Linhcry/modular-robot-pet/docs/02_电机来源与接口决策.md

# 电机来源与接口决策

记录日期：2026-09-05。阶段：结构设计。本文不构成采购订单；价格只用于方向比较，驱动板选项与正式报价尚未冻结。

| 型号（不得与 V3.0 混用） | 厂家额定扭矩 | 峰值扭矩 | 电压 | 厂家尺寸 | 厂家参数表质量 | 拟评估用途 |
|---|---:|---:|---:|---|---:|---|
| CubeMars AK40-10 KV170 | 1.3 N·m | 4.1 N·m | 24 V | 直径53×37 mm | 185 g | 轻载偏航、手臂末级；承载髋轴须另算力矩 |
| CubeMars AK45-10 KV75 | 2.5 N·m | 7 N·m | 24 V | 直径53×43 mm | 260 g | 髋部俯仰、机械臂肩部候选 |
| CubeMars AK45-36 KV80 | 8 N·m | 24 N·m | 24 V | 直径55×54 mm | 340 g | 承载膝轴候选 |
| 飞特 STS3215，7.4 V 规格书版本 | 约0.490 N·m | 堵转约1.91 N·m | 7.4 V | 45.23×24.73×35 mm壳体 | 55 g | 头部、尾部、夹爪、舱盖候选 |

## 可在中国购买的型号证据

CubeMars 中文官网均有购买入口、国内配送及支付宝信息：

- [AK40-10 KV170](https://www.cubemars.com/cn/product/ak40-10-robotic-actuator.html)
- [AK45-10 KV75](https://www.cubemars.com/cn/product/AK45-10-robotic-actuatuor.html)
- [AK45-36 KV80](https://www.cubemars.com/cn/product/AK45-36.html)
- [飞特 STS3215 厂家产品索引](https://www.feetechrc.com/products.html?keyword=STS3215)

AK40-10 页面宣传段落另出现200 g，与核心参数表185 g矛盾。当前表格明确采用参数表值，质量预算需另加配线与安装余量。飞特索引包含12 V与7.4 V版本；已下载规格书属于7.4 V版本，不能拿该文件的电气额定参数替代12 V版本。

## 已保留原始资料

- AK45-10 厂家 STEP 压缩包已完整下载并通过 ZIP 校验；内部文件由 SolidWorks 2020 导出，AP214，文件日期2025-02-28。
- AK45-10、AK45-36、AK40-10 厂家二维尺寸图。
- AK40-2410-1A-A1 驱动器安装说明 V1.0.2，以及 STS3215 7.4 V 规格书。
- 原文件放在 `vendor/motor_sources/`。厂家文件保留原貌，自制模型不得伪装成厂家原始模型。

## 接口建模规则

1. 旧 J01/J02 为早期几何假设，不能作为最终电机或采购件。后续必须用明确型号替换，或改为有来源的外形/接口简化模型。
2. AK40-10 尺寸图显示五个 M2.5、深5的孔位于直径45分度圆；另一端直径47.5与27分度圆上分别三孔，深度分别5与3。定子与输出端角色需对照厂家三维结构再冻结安装方式。
3. AK45-10 与 AK40-10 外径相同不代表轴向尺寸、输出位置与安装螺纹深度完全相同。AK45-36 孔型又不同，不允许沿用早期44方孔。
4. 未核实的背面插头、配线弯曲半径和散热空间应作为独立避让包络，不能用不明孔位制造安装件。
5. 驱动器说明列明：额定24 V、允许16–28 V、CAN 1 Mbps；电源接口 XT30PW-M 配 XT30U-F，串口 A1257WR-S-3P 配 A1257H-3P，CAN A1257WR-S-4P 配 A1257H-4P。驱动板安装孔2.1 mm、推荐M2螺钉，不能套用电机壳体M2.5孔。

## 选型冻结前的力矩与质量检查

峰值或堵转扭矩不作为持续承载指标。例如300 g物体在距肩轴240 mm处，仅物体产生约0.706 N·m重力矩，已高于所下载STS3215的额定扭矩，还没有计入手臂自重。因此该舵机不直接承担长臂肩关节。

若四腿分别采用每腿两台AK45-10与一台AK45-36，仅腿部12台电机的参数表质量就达3.44 kg。这会明显挤压4–5 kg整机目标留给结构、机械臂、电池与计算模块的余量。该组合尚未冻结；需结合CAD质量、支撑姿态与减重方案选择，不能把初选型号等同于整机指标已达成。

后续应建立各承载轴的最差静态姿态、运动峰值、持续工作占空比、温升与跌落工况，再确定驱动等级。CAD可验证外形、装配和部分运动包络，不能单独证明爬楼承载性能。
