Linhcry/modular-robot-pet/docs/04_电机载荷计算与减重决策.md

# 电机载荷计算与减重决策

版本 P1.1，2026-09-05。当前是选型筛查，尚未锁定最终电机，也未进行实物试验。

## 结论与设计变更

现有厚板、转接盘和长滑靴组合不能按 4–5 kg 目标直接推进。按已建实体体积、拟装数量、候选完整电机质量及尚未建成部件的质量预留，本体估计 **10.337 kg**，另有 300 g 货物。这不是总装质量属性或成品称重；详细数量与证据逐项列在 `data/当前架构质量估算.csv`。

新增 F10/F11 减重承载板和 B01/B02/B03 曲面护罩为独立候选件，不覆盖已检查的原版。它们的实际生成与重建状态以 `validation/减重框架与护壳检查.json` 为准；脚本存在不等于模型已成功生成。两个薄板不能只凭减重比例就代替刚度、屈曲和连接强度校核。

最终电机必须同时满足计算和大工程师模型来源要求。AK45-10 厂家模型及已建关节装配保留为接口研究；不能将其描述成已经从大工程师取出的最终电机。

## 输入与可复算文件

- `scripts/measure_part_volumes.py`：逐件打开原生模型、读取体积、关闭；密度假设保存在 `data/零件体积与质量假设.csv`。
- `scripts/size_actuators.py`：质量预算、三轴腿静力/集中质量动力筛查、60 s 载荷谱 RMS、辅助关节载荷。
- `data/腿部电机工况计算.csv`：每个关节、姿态、地面力、加速项、速度项、裕量、转速和持续时间。
- `data/腿部连续力矩筛选.csv`、`data/辅助关节载荷计算.csv`：选型输入。
- `validation/电机载荷初算.json`：汇总与数值检查。修改长度、质量、速度、载荷分配后必须重算。

材料密度暂按 6061 铝合金 2700、PA12 1010、TPU 1200 kg/m³ 等设计值。打印件按完整实体估计；填充、嵌件、表面处理和制造差异需要后续实测。V01/V02 是同一电机的接口参考，不能各按一台电机计重。标准螺钉未逐颗叠加到质量总表，而由整机紧固件预留项覆盖，避免重复。

## 腿部模型与方法

坐标 X 向前、Y 向左、Z 向上；大腿、小腿轴距均为 145 mm，髋外展轴至髋俯仰轴横向偏置暂定 50 mm。外展角为 r，髋俯仰为 h，膝俯仰为 k，俯仰零位是竖直向下。

足端位置：

`p = Rx(r) · [L1 sin(h) + L2 sin(h+k), 0.050, -L1 cos(h) - L2 cos(h+k)]`

每个雅可比列为 `轴方向 × (足端位置 − 关节原点)`；地面力对应 `τ = JᵀF`。该静力关系依据 [Modern Robotics：速度运动学与静力学](https://modernrobotics.northwestern.edu/nu-gm-book-resource/velocity-kinematics-and-statics/)。脚本采用两种可手算姿态及中心差分验证雅可比，当前最大误差约 2.63×10⁻¹¹ m/rad。

地面垂向载荷取 `Fz = 满载质量 × g × 动载系数 × 单脚载荷份额`；Fx/Fz、Fy/Fz、各关节速度和角加速度均在脚本中明确列出。它们是筛查假设，不是已规划的真实步态时序。

连杆/转接件/膝电机/足部暂按集中质量计算 `M = Σ m JpᵀJp`；利用 M 的差分导数计算科氏与离心项，遍历给定速度幅值的 8 种方向组合。加速项按各耦合分量绝对值求和。最后将地面力矩、腿重、集中质量加速项和速度项的幅值相加，再乘 1.25 筛查裕量。这保留了集中质量模型的耦合，但不等于完整刚体逆动力学。转子反射惯量、零件自身转动惯量、内部减速摩擦、弹性和接触冲击尚需补入。

由于姿态、载荷和速度采用组合边界，筛查值可能高于某条可实现慢速轨迹的实际需求。不能用一次边界筛查直接断言某电机绝对无法行走；也不能用静态通过证明跳跃、跌倒翻正或连续楼梯通过。

## 初步数值

60 s 示例载荷谱：安静站立 30 s、三脚慢走 12 s、伸爪支撑 8 s、低姿爬行 5 s、爬阶推升 5 s。RMS 为 `sqrt(Στ²t / Σt)`，不是各工况峰值的算术平均。

| 本体场景（另加300g） | 髋外展 RMS | 髋俯仰 RMS | 膝俯仰 RMS |
|---|---:|---:|---:|
| 5 kg 目标场景 | 3.001 N·m | 2.122 N·m | 3.259 N·m |
| 当前架构约10.337 kg | 5.163 N·m | 3.570 N·m | 6.254 N·m |
| 7 kg 敏感性场景 | 3.811 N·m | 2.659 N·m | 4.381 N·m |

均含 1.25 筛查裕量；腿部局部质量尚采用当前候选构成，整机减重后必须同步修改这些局部质量。

在 5 kg 目标场景下，爬阶推升组合边界对应髋俯仰约 6.203 N·m/47.75 rpm，膝俯仰约 7.500 N·m/66.85 rpm。小跳起蹬的膝转速边界为 171.89 rpm。故不能看到高减速比型号扭矩较大就直接选为膝电机。

单脚误着地另外列为故障边界；不能将它混入普通动作通过率。跌倒翻正需要加入身体圆弧接地、重心位置、滚动过程和腿推力轨迹，目前没有计算闭环，保留为未完成项目。

## 候选电机对照

| 候选 | 厂家公开额定/峰值 | 转速/质量 | 本轮判断 |
|---|---|---|---|
| CubeMars AK45-10 KV75，非V3 | 2.5/7 N·m | 额定150 rpm；260 g | 当前组合边界下髋外展连续需求不足；髋俯仰还有热条件和峰值时间待核。仅作候选接口研究 |
| CubeMars AK45-36 KV80，非V3 | 8/24 N·m | 额定40 rpm、空载52 rpm；340 g | 具有低速扭矩，但当前快动作转速边界不满足；不能按24 N·m概括为全动作适用 |
| 大工程师：姜莱 BK10 | 库中已选到BK10规格；属于减速机 | 完整电机与驱动参数未取得 | 不能当作一体化电机。下载对话框已出现，尚未成功保存模型 |
| 大工程师：CHAMP系列、KGU系列 | 已看到产品条目 | 具体可选规格尚待进入详情 | 继续检索，尚未选型 |
| 大工程师：德晟120 kgf·cm总线舵机 | 已看到库条目 | 连续扭矩、实际型号和质量未取得 | 不能把标题里的kgf·cm当连续工作扭矩 |

AK 系列数据来自 [AK45-10 厂家页](https://www.cubemars.com/cn/product/AK45-10-robotic-actuatuor.html) 和 [AK45-36 厂家页](https://www.cubemars.com/cn/product/AK45-36.html)。V3 的轴向尺寸及编码器配置不同，不能与现有非V3接口混用。页面电流口径和减速器效率也不能擅自换算成电池峰值功率。

连续/RMS、峰值允许时间及转速必须联合筛选，并核对驱动器和实际散热条件，参见 [Kollmorgen AKM2G 性能曲线说明](https://www.kollmorgen.com/sites/default/files/public_downloads/AKM2G%20Performance%20Curves.pdf)。封闭宠物外壳中的热条件不能沿用大型散热板条件。

## 辅助关节

300 g 货物、双120 mm连杆、末端腕120 g和夹爪160 g、肘电机185 g的假设下：

| 位置 | 含1.5裕量的初步驱动轴需求 |
|---|---:|
| 肩俯仰，水平伸展 | 2.968 N·m |
| 肘俯仰 | 1.224 N·m |
| 腕俯仰，物体质心距腕60mm | 0.402 N·m |
| 头俯仰，头220g、质心偏40mm | 0.181 N·m |
| 舱盖，含铰链80g | 0.117 N·m |
| 尾部竖直轴摆动 | 0.037 N·m |

夹爪以摩擦系数0.3、上提加速度2 m/s²、抗滑系数2计算，每指约需11.807 N法向力。若两指各40 mm力臂并由同一驱动同步，传动效率暂按0.7，则驱动轴需求约1.349 N·m。软包、钥匙薄边和低摩擦遥控器不应共用未经验证的抓取假设，需分别测试并保留托取指尖。

肩部优先研究近端布置电机、传动减速和重力补偿，避免把小舵机直接放在长力臂末端。腰转、头偏航和腕旋转还需要基于最终轴系与惯量补算，不能因重力绕竖直轴为零而认为无需选型。

## 减重路线与约束

1. 主板采用连续周边承载环、横向连接带及大圆角减重窗；孔位要落在承载带上。
2. 把关节适配盘与连杆端部整合，减少重复法兰与紧固件。电机库模型冻结前保持可修改接口。
3. 膝驱动研究近髋布置和同步带/并联连杆传动，降低摆腿惯量；新增轴承、同步轮、带预紧及传动损失全部纳入质量与扭矩预算。
4. 储物滑靴研究四个短滑靴替代两条长实心滑靴；防退出机构需要正向保持，不能依靠销自身重量。
5. 薄壳仅承担保护和外观，承载面与局部筋板保留平面。止口用于接缝定位，紧固件或锁扣另行承担保持。
6. 圆角半径、壳厚、通风和关节扫掠一起迭代。外观通过还须查看总装比例、缝隙、颜色及多姿态，而不是仅检查单件放样成功。

当前没有采购、询价消息发送或费用支出。用户正在使用电脑期间，暂停大工程师的前台鼠标键盘操作，继续计算、参数化脚本和后台CAD工作。
