Linhcry/modular-robot-pet/docs/05_减重候选与质量分配.md

# 减重候选与质量分配

日期：2026-09-05。保留原架构基线，不把独立候选当作已经完成的整机。

将 F10、F11、两件 F12、四件 Q05 代入，再用实际生成的两片机身壳和四件关节罩替换原来350g护罩预算，本体估计由 **10.337kg** 变为 **9.662kg**，净减重约 **675.0g**，距5kg仍差 **4.662kg**。这些质量来自原生实体体积、拟装数量和材料假设，并非称重结果或装配体质量属性。

| 变更 | 原估重g | 候选估重g | 减重g |
|---|---:|---:|---:|
| 下承载板 → 镂空下承载板 | 652.2 | 196.0 | 456.2 |
| 上承载板 → 双承载带上板 | 336.6 | 126.6 | 210.0 |
| 两条312长侧梁 → 两条300长避空侧梁 | 289.0 | 277.8 | 11.2 |
| 两条长滑靴 → 四个短滑靴 | 140.5 | 41.5 | 99.1 |
| 躯干护罩预算 → 两片机身壳+四个关节护罩 | 350.0 | 451.4 | -101.4 |

现有腿电机、辅助驱动、电池电子及线束紧固件的预留合计已约 **5.390kg**，尚未计入承载框架、四腿杆件、储物舱或机身壳。因此，继续给现有板件开孔不可能独自解决5kg目标；必须重做驱动和结构的一体化方案。

## 下一步设计门槛

1. 暂停冻结现有 AK45 接口为整机最终接口。按当前质量构成，12台完整驱动共3.44kg；目标分配暂为2.10kg，即平均175g/台。这是反推上限，不是已经找到满足力矩与寿命的电机。
2. 保留三轴腿和拾取机械臂任务。比较近髋膝驱动、共用轴承支承、连杆端与输出盘合并等拓扑，把新增传动件、损耗、预紧与维护空间一并计入。
3. 壳体预算需同时保留壁厚、局部连接柱和耐碰能力；不能把当前2.2mm壁厚按质量比例直接缩到不到1mm。
4. 对每个候选先计算慢走与爬阶的连贯轨迹，再核对扭矩—转速—峰值持续时间—散热。大工程师具体规格及模型未取得的候选不能定型。
5. 目标仍为本体4–5kg，另加300g载物。本报告不自动放宽目标、不触发采购。

## 5kg分系统目标

| 分系统 | 分配g |
|---|---:|
| 12台腿部驱动总成 | 2100 |
| 全部腿结构及传动支承 | 650 |
| 机身承载框架及模块接口 | 450 |
| 机械臂与夹爪含全部驱动 | 650 |
| 头尾储物舱含驱动 | 300 |
| 电池与电源保护 | 350 |
| 算力视觉音频 | 200 |
| 护壳 | 180 |
| 线束与全机紧固件 | 120 |

分项均为设计约束，尚无完整BOM满足；可在总额内调配。模型、质量表和载荷表一致后，才能作为进入加工或采购阶段的依据。
