Linhcry/modular-robot-pet/docs/06_单脚阶梯转移时序计算.md

# 单脚阶梯转移的连贯轨迹计算

2026-09-05；初步运动学/集中质量动力学，未验证整机连续楼梯。

按同一条抬脚、前移、缓降轨迹计算关节角、转速、角加速度和有符号力矩，避免把不同时刻的速度与扭矩峰值配成一个实际工况。每段使用端点速度和加速度均为零的五次曲线。抬脚0.8s，前移0.8s，落脚0.5s；足参考X从−20mm到130mm，假设阶沿X=40mm、脚参考点越过台阶顶15mm。

| 阶高/髋高 mm | 关节 | 角范围 ° | 最高转速 rpm | 摆动峰值 Nm | 峰值扭矩时转速 rpm | 摆动 RMS Nm |
|---|---|---:|---:|---:|---:|---:|
| 150/245 | 髋外展 | -0.0～0.0 | 0.0 | 0.545 | 0.0 | 0.492 |
| 150/245 | 髋俯仰 | -87.5～0.2 | 38.5 | 0.681 | 0.0 | 0.437 |
| 150/245 | 膝俯仰 | 64.1～148.0 | 31.6 | 0.236 | -9.7 | 0.199 |
| 180/275 | 髋外展 | -0.0～0.0 | 0.0 | 0.545 | 0.0 | 0.492 |
| 180/275 | 髋俯仰 | -87.5～0.2 | 38.5 | 0.681 | 0.0 | 0.415 |
| 180/275 | 膝俯仰 | 36.1～148.0 | 41.0 | 0.236 | -9.7 | 0.194 |

180mm阶高若仍保持245mm髋高，当前点足轨迹的膝最大角达160.1°；髋高提高至275mm后减少到148.0°。这表明上阶前身体高度必须参与规划，不能只抬小腿。这里的150°是观察线，尚未获得最终关节及足端实体全程无碰撞证据。

两种时间步长4ms和2ms的峰值力矩差已记录；IK回代已数值核对。此处扭矩均未乘选型裕量，仅为单腿摆动。支撑腿、翻正、跳跃、地面摩擦、电池功率和温升仍须分别验证；不能据此宣称整机已经能爬180mm楼梯。

方法沿用[Modern Robotics 的速度运动学与静力学](https://modernrobotics.northwestern.edu/nu-gm-book-resource/velocity-kinematics-and-statics/)，集中质量 M、重力和科氏项由现有模型计算。原始采样见 data/单脚150mm阶高转移时序.csv 和 data/单脚180mm阶高转移时序.csv。
