Linhcry/modular-robot-pet/docs/10_智能舵机候选与驱动筛选.md

# SM80BL智能舵机候选与传动筛选

2026-09-07。用户授权自行决定电机或舵机。本报告为候选筛选，不是最终选型或采购清单。

厂家2024-06-07 A/0规格书给出97.5±1g、46.5×28.5×34mm、RS485、位置/电流/温度等反馈，内部减速比353:1。第6–7页已视觉检查尺寸与曲线；不能按低减速比准直驱的背驱性能使用。

| 版本 | 标称额定 Nm | 堵转 Nm | 空载 rpm | 输入范围 V |
|---|---:|---:|---:|---|
| 12V | 1.961 | 7.845 | 62 | [9, 12.6] |
| 24V | 2.059 | 8.336 | 70 | [16.8, 25.2] |

本地厂家原件：[12V规格](../vendor/SM80BL_12V_厂家规格.pdf)、[24V规格](../vendor/SM80BL_24V_厂家规格.pdf)。[12V公开产品页](https://www.feetechrc.com/552209.html)。

## 筛选约定

沿用旧质量模型以隔离传动拓扑影响，三个局部支撑姿态的绝对力矩乘1.3，再除0.85作为传动不确定度余量。静态保持没有功率效率，这里的0.85是保守代理。比较额定值仅表示本设计采用“不依赖短时过载”的预筛，不证明超过额定的短动作绝对不可行。没有解全机平衡，也没有实测热曲线。

| 24V，外部比 | 轴 | 静态带余量 Nm | 对额定比 | 摆动最高 rpm |
|---|---|---:|---:|---:|
| 2 | 髋外展 | 2.096 | 1.02 | 0.00 |
| 2 | 髋俯仰 | 1.796 | 0.87 | 38.46 |
| 2 | 膝驱动 | 2.701 | 1.31 | 59.97 |
| 3 | 髋外展 | 2.096 | 1.02 | 0.00 |
| 3 | 髋俯仰 | 1.227 | 0.60 | 38.46 |
| 3 | 膝驱动 | 1.801 | 0.87 | 100.97 |

R2使膝扭矩降低，但带余量静态需求仍超过额定；继续加大比例又会增加近端驱动转速。不能把各自发生在不同时间的最大扭矩、最大速度拼成同一负载点。另一个CSV逐时刻检查R2轨迹：只在正机械功率区，用厂家直线速度曲线端点近似；制动和再生区单列为未验证。

厂家同时标注空载速度和堵转扭矩±10%。将两端点都下调10%的敏感性预筛中，12V的R2近端膝驱动已超出近似速度曲线，24V在当前电动摆动区仍有余量；这不是实测四象限工作包络，也不能覆盖静态额定、回生和温升问题。

## 本阶段设计决定

- SM80BL不作为全腿12轴通用直接替换；保留不同轴采用不同驱动的路线
- R2近端膝驱动继续研究，但本次带余量静态额定筛选未全通过
- 轻载头尾无需97.5g大舵机；优先更小的反馈舵机另核算
- 机械臂肩轴原需求约2.97Nm，SM80直接驱动额定不足；继续比较外部减速或更高额定型号
- 所有动力件在大工程师取得确切型号模型后再冻结接口；当前不采购

## 规格边界

- 24V输入上限25.2V与第5页默认过压25V不一致，电源阈值须确认
- 第6页寿命动作60度/0.25s与同栏30或35rpm口径待确认
- 规格书额定负载符号为20/21kg.cm≤；本筛选保守采用标称数，不解释为完整连续热包络
- 无外部径向/轴向承载及背驱测试数据
- 1kHz最大位置更新率不等于12轴总线实际全反馈频率

不能将80/85kgf·cm堵转扭矩当成连续能力。过流超过2.5A持续2s会关断输出，过温70°C也会关断；动作控制器必须识别故障并有序恢复。

舵盘图示外径18.8、4-M3孔在直径14分布圆、中心孔3.1、总厚5.4mm；图中25T文字仍写SM40BL，属于厂家图纸型号标注待核项。对侧凸台/支承面、30处M3×3深孔及线束出口需与实际大工程师模型交叉校验，尚未自制接口替代厂家模型。
