Linhcry/modular-robot-pet/docs/15_触控视觉头部与智能化接口规划.md

# 触控视觉头部与智能化接口规划

2026-09-08。本阶段完成结构候选和接口规划，不代表相机识别、触摸系统或大模型已在机器人上运行。沿用用户要求：中文独立零件、真实装配配合、后台建模、后续再采购。

## 头部机械接口

头壳 H04 采用四截面圆角放样和 2.5 mm 抽壳，后部曲面过渡至前端 104×96 mm 平面。H05 面框厚 2.2 mm，H06 承架厚 2 mm，H07 为独立黑色柔性密封圈。四个自制零件分别保存，旧 H01/H02 保留作历史方案。

四件自制结构按原生体积及材料密度假设合计125.25g，尚不含屏幕、相机、颈驱动、紧固件、算力和线缆。相对于旧H01/H02两件54.28g增加约70.97g；新方案增加了触控屏承架与齐平收口功能，并不是减重成果。旧整机9.662kg估算尚未合入所有最新候选，当前也没有证明满足4–5kg目标。

微雪 2.8inch DSI LCD 原厂 STEP 已保留并派生为 V03 中文原生参考零件，共 10 个实体。屏幕横置；原厂坐标到头部坐标为 X=-原Y-2，Y=原X-12，Z=原Z+61.1（mm）。玻璃外形名义 71.3×52.9 mm，面框开口 72.3×53.9 mm，周边 0.5 mm 刚性间隙由黑色柔性圈收口。按用户新增“无缝嵌入、高级感”要求，玻璃、面框、柔性圈前面均为 Z62.2，名义齐平；旧凹入0.8 mm方案已取代。

柔性圈总高 1.6 mm，装配原点 Z60.6。背部承边外形76.3×57.9 mm、厚0.6，面框沉台外形76.7×58.3 mm、深1.2；背面一圈0.6 mm薄唇将承边捕获在Z60.6至61.2之间。柔性圈从背面安装，承边弹性变形越过防脱唇，再恢复到槽内，避免圈体轴向游动使齐平面下陷。薄唇入口75.3×56.9 mm，过唇安装时每侧约需0.5 mm临时弹性变形。前方可见唇宽名义0.5 mm，与暗色面框配色统一。

上述为装配态名义几何，未模拟柔性变形。硅胶硬度、自由态过盈、成型收缩、公差、0.6 mm打印薄唇的成型/拆装耐久均需试样验证；不能直接把此装配态零件图当成模具图。真正的外观齐平还受玻璃/螺柱高度公差和承架装配偏差影响，后续通过试装确定垫片调整量；不采用刚性零间隙挤压玻璃。黑色柔性收口旨在隐藏亮缝，不宣称达到防水等级。

四个厂家螺柱轴线变换后 X=-29.35/30.12，Y=8.45/-32.45。孔距 59.47×40.90 mm，不能用对称居中孔距代替。螺柱后端平面由实体平面读取为原 Z=-9.9，变换后 Z51.2；承架顶同为 Z51.2，底为 Z49.2，头壳内部支承肩顶为 Z49.2。

原厂模型将螺柱命名为 M2.5，但内孔几何约 D1.76，与常规 M2.5 底孔口径不一致。承架先做 D2.9 通孔；紧固螺钉长度、有效啮合和螺柱具体供货版本待交叉确认，不能把模型孔径直接标成攻丝尺寸。

承架与头壳的四个M3孔已从X±37外移到±39，Y仍为±28。用SolidWorks临时实体对厂家屏幕做布尔相交，旧下方两孔的D5直进工具通道各与触控玻璃交叠约3.753mm³；外移2mm后清除。孔横距因此由74改为78mm。旧X37原生件和已交付PDF已留在wip历史目录，新图应使用78mm孔距。

`触控视觉头部_承架紧固候选.SLDASM`在五组件空间总成上增加四组M3×10螺钉、上下各一片0.5mm垫圈和2.4mm螺母，共21组件、44配合。夹紧路径为螺钉头→上垫圈→2mm承架→2.5mm头壳环肩→下垫圈→螺母，螺钉穿出螺母2.1mm。所有新增连接采用实际孔同心和承压面贴合，重开后无实体干涉；面框未安装时四处D5×60直进工具杆也避开头壳、屏幕和连接件。螺母防掉落、背面扳手路径及PA12预紧压溃/蠕变仍未解决，故仍是紧固候选。

2026-09-08已在国家标准全文公开系统核实：[GB/T70.1-2008内六角圆柱头螺钉](https://openstd.samr.gov.cn/bzgk/std/newGbInfo?hcno=AA481BA038B2F9CE68879E6B087F4F73)、[GB/T97.1-2002平垫圈A级](https://openstd.samr.gov.cn/bzgk/std/newGbInfo?hcno=199E0585386FDF8B9CACF6225BA5F924)、[GB/T6170-2015的1型六角螺母](https://openstd.samr.gov.cn/bzgk/std/newGbInfo?hcno=BDDE5AF77AC2FBC2D194289F10C69A4B)均为现行。螺母按该尺寸族预选，M3对边最大5.50mm、厚度最大2.40mm已通过[嘉立创FA尺寸表](https://www.jlc-jdgf.com/mcbook/GBT6170-2000.htm)交叉核对，与现有简化包络一致。尺寸族明确不等于实购件性能、镀层或全公差合格；材料等级、供应商货号与大工程师对应模型仍待冻结。详见`data/触控头部承架紧固装配清单.csv`及`validation/头部紧固件国标与装配清单核对.json`。

相机暂用独立于屏幕的上方区域：承架避空 26×25 mm，中心 Y30；面框镜头窗口 D16。将来相机装在可换小托架上，允许更换镜头/相机而只改局部零件。当前没有冻结相机孔距、镜头前伸量和视场锥，所以 D16 是空间预留，尚未证明视场无遮挡。屏幕玻璃前面不叠加机械展示用亚克力板。

相机采购候选进一步对应到Pi5-IMX219-77（SKU26184），厂家标称25×24mm板、6.5×6.5mm镜头、79.3°对角视场、2.85mm焦距和F2.0。按直线投影、名义入瞳半径0.7125mm及暂定0.5mm偏心预算，D16孔允许入瞳距面框前面后缩约8.19mm，即入瞳Z须不小于54.01mm。若入瞳在Z53，所需半径约8.84mm，孔径不足；Z55时名义径向余量约0.82mm。该预筛约束的是**入瞳位置，不是PCB位置或镜片表面**；真实入瞳、孔位、镜头前伸与实拍遮挡尚未取得，因此不能据此固定托架高度。计算见`validation/相机D16窗口条件预筛.json`及`scripts/screen_camera_aperture.py`。[厂家参数](https://www.waveshare.net/shop/Pi5-IMX219-77.htm)。

内部四个 2.5×10 mm 圆角扎带槽用于线束应力释放，后壁 D18 穿线口设 C0.3 去锐边。扎带槽不等于完整线束路径；排线端接、弯曲半径、护套、防拉脱和装配步骤仍须建模。安装结构必须把触摸按压力从屏幕螺柱传给承架与环肩，不能靠玻璃边缘硬顶面框承力。

## 计算与感知位置

高层控制候选为 Raspberry Pi CM5 + 微雪 CM5-NANO-A 底板，负责视觉、语音、表情、设置和网络模型接入。底板厂家 STEP 的首轮导入失败已恢复：改用ASCII临时路径、整体多实体导入并关闭自动导入诊断，本轮成功保存V04原生参考件，包含337个实体，原件约22.9MB。

V04保留厂家坐标：整体包围盒约X161.365至217.600、Y259.832至299.850、Z-2.800至9.000mm。厂家实体009为PCB，厚1.6mm；整体包围盒是CAD近似值，不能用它代替精确安装基准。PCB上已提取的圆柱孔全部小于1mm直径，未在厂家模型中找到常规安装螺钉孔，不能沿用核心板孔距直接给底板打孔。底板固定优先研究绝缘板边卡槽/压条，并核对器件与铜层禁压区；核心板、散热器和全部接插件尚未装入。

模型也需要与产品照片/原理图对照：尤其核验核心板板对板连接器和背面器件的三维完整性。厂家STEP存在并不意味着所有实物器件都画全，不把看似空白的背面当作已确认的支承面。[厂家产品与接口说明](https://www.waveshare.net/shop/CM5-NANO-A.htm)。

本轮已下载厂家原理图并作位号交叉核对。原理图中的CM1A/CM1B、J1/J3、H3/H5及按键/指示灯没有同名STEP产品标签，而USB-A、USB-C、MicroSD和GPIO位号能够对应。原始STEP没有开放曲面壳，不能简单归因于只导入实体而漏了开放曲面。此结果只证明标签追踪不完整，通用名称仍可能代表相关器件；后续须以几何位置或实物确认，详见`validation/CM5底板厂家三维覆盖核对.json`。[厂家原理图](https://www.waveshare.net/w/upload/8/85/CM5-NANO-A_Sch.pdf)。

CM5官方STEP及38页数据手册已通过公开官方链接下载并保留哈希。手册给出核心板55×40mm、PCB厚1.24mm±10%、四个M2.5安装孔距板边3.5mm。连接器选型会使叠层高度为1.5或4mm；对应安装后模块高度4.94或7.44mm。无线板载天线周围至少留10mm净空，天线下方不应直接放金属。上述尺寸用于核心板支承与避空规划，不能直接套用到底板；本项目还须核验实物版本及选用连接器。[官方数据手册，第16–17页](https://datasheets.raspberrypi.com/cm5/cm5-datasheet.pdf)、[官方设计文件](https://pip.raspberrypi.com/categories/1096-design-files)。

官方CM5R5 STEP已转换为`V05_树莓派CM5核心板官方参考.SLDPRT`，1076个实体，文件48,067,138字节；保存关闭后查看了预览。整体厂家坐标包围盒X0至55、Y0至40、Z-1.110至3.511mm。V05与V04仍是独立参考件，未假装已经完成板对板连接、散热或与头部的装配。

重开后的精确极值与孔轴提取：V05四孔圆柱直径2.7mm，轴线为X3.5/51.5、Y3.5/36.5，孔距48×33mm；这是M2.5螺钉的通孔几何，不能标成板上M2.5螺纹。V04大面积板体实际外形55.0186×40.0180mm，厚约1.6mm，仍无D1.6至4.2mm且垂直板面的圆柱孔。V05选中板体实体的厚度1.0762mm不能代替完整PCB叠层：原始文件含DIELECTRIC产品定义，夹紧厚度仍须厂家版本与手册核验。原始数值及SHA256见`validation/CM5核心板与底板精确接口.json`。

厂家明确提供一个 CSI 摄像头和一个 DSI 屏幕同时连接的示例。具体 2.8 寸屏驱动应使用该屏对应配置，不能直接沿用底板示例的 7 寸屏配置。[CM5-NANO-A 厂家说明](https://www.waveshare.net/wiki/CM5-NANO-A)、[2.8 寸屏厂家说明](https://www.waveshare.net/wiki/2.8inch_DSI_LCD)。

计算板装头部或机身尚未冻结。装头部可缩短 MIPI 线，却增加颈部惯量和触摸附近的热量；装机身可减轻头部，但必须验证穿颈线长、连接器空间与活动弯曲寿命。厂商示例 12 cm 屏排线不能直接视为本机够用。下一步先装入底板、CM5、散热器及连接器完整包络，再比较两个位置；给散热器留空间也不等于热设计通过。

## 智能体分层

| 层 | 职责 | 与机械有关的约束 |
|---|---|---|
| 触摸与表情界面 | 眼睛表情、音量、网络、模型选择、电量、模式设置 | 可触达、可清洁；界面旋转和触控坐标一致 |
| 感知层 | 摄像头、麦克风、IMU、距离/接触传感器；输出物体和环境状态 | 相机视场、麦克风隔振、热源与噪声距离 |
| 行为管理器 | 将“过来”“坐下”“打开储物舱”等意图映射到有限动作技能 | 每项技能有前置条件、运动边界、超时和恢复过程 |
| 模型适配器 | 按统一接口接入 GPT、DeepSeek 等服务，保存会话上下文 | 密钥在设置中管理；网络失联时基础交互仍可用 |
| 本地动作规划 | 关节轨迹、步态、姿态转换、夹取和储物流程 | 使用实际关节限位、载荷和碰撞模型 |
| 独立实时控制器 | 总线收发、位置/电流/温度反馈、看门狗、停止与恢复 | 与高层计算分离；按实测总线周期控制驱动 |

模型仅提出动作意图和参数，由本地行为管理器检查并执行。屏幕上的急停按钮只是辅助操作入口；实体停止控制及硬件执行路径要纳入电气设计。云端响应慢、模型错误或 Linux 界面退出时，实时控制器仍须有明确的关节保持/卸载策略，不能随意全部断力导致跌落。

## 配电与走线后续工作

- 将电机电源、逻辑电源和屏幕/相机线束分组，连接器有清楚的拔插方向和维护余量，强电不压住 MIPI 排线。
- SM105 候选是 9–16 V 输入；4 串锂电池充满 16.8 V 超出此范围，不能直接沿用为电源。电池串数、降压、回生吸收与保护待完整功耗和供电方案确定。
- 12 轴各自额定电流相加为 25.2 A，只能作为电源工况筛查输入，不能当作真实平均耗电或直接计算续航。动作占空、回生、压降和散热都须补齐。
- 总线安排要按真实指令/反馈帧长度、半双工换向时间和重试负荷计算；厂家标注单舵机 1 kHz 更新率不等于全机 12 轴都能达到此频率。
- 颈部采取有限角度活动和可维护线环，先明确目标偏航/俯仰范围，再用离散姿态与连续运动检查夹线。不能在普通排线条件下承诺无限旋转。

## 本轮验证边界与接续顺序

当前四件头部原生件与齐平面以`validation/触控头部最终孔轴复核.json`为准；21组件44配合紧固总成以`validation/头部承架紧固与工具空间检查.json`为准；完整/面框拆下/恢复完整配置及五页图纸以`validation/触控头部图纸交付复核.json`为准。五页合册首张已更新为紧固总成，主视图显示面框拆下状态，四张零件图使用78mm新孔距。当前头部不是制造释放总成，尚无屏幕螺钉、面框紧固件、相机小托架和完整线束。

接续顺序：齐平面与防脱圈几何复核 → 更新独立零件工程图和装配图 → 屏幕螺柱版本确认及紧固件 → 柔性圈试样/尺寸补偿 → 相机实际孔位与视场 → 计算板及散热布局 → 颈部负载和线束行程 → 与机身、机械臂、储物舱总装。驱动方面保留 SM105BL-C001 + R1.5 作为可深入设计的候选，须补大工程师对应型号模型、传动部件质量、承载轴承和热工况后才能最终选型。

## 2026-09-08 螺母防落改版与STEP完整性问题

H10/H11曲面定位头壳及长臂螺母杯已各自保存为原生单实体零件，零特征重建错误。新杯原点Z37.6，名义卸载间隙0.6mm；完整装配、安装路径与新工程图尚未完成。杯内独立检查完成4种状态、6个旋转反例，不代表头壳或实物装配通过。

轻量独立读取发现H04/H08/H10 STEP各有两条缺失曲线引用，不能用其不完整转换体验证无干涉。旧审阅包内的H04 STEP确认受影响，已补已知问题说明，并在重打包前增加拦截。原生SLDPRT是否存在相应几何问题尚需SolidWorks检查。详见 docs/16_螺母防落结构与STEP导出接续.md。
