Linhcry/modular-robot-pet/docs/03_储物舱与真实关节设计记录.md

# 储物舱与真实关节设计记录

日期：2026-09-05。阶段：P1 结构设计，未制造释放。此文件记录已经落实到原生模型的接口，不表示整机已经完成。

## 中文命名与保存

自制零件、采购参考件、装配文件及工程图均采用“编号＋中文功能名称”。保留 AK45-10、M2.5 等型号与规格。每个新零件建成后独立保存为 SLDPRT 并关闭，再按模型引用创建装配。厂家原始 STEP 与其原始结构另存，不能以简化件取代来源证据。

## 储物舱

- 储物舱模块包含 47 个实例、92 个真实配合。壳体是固定基准；舱盖采用同心轴线、轴向定位和可调角度配合。
- 舱体为圆角硬壳，盖体采用多截面放样与抽壳；安装处保留平面及螺纹凸台。
- 内托盘由四个支承柱托起，以避开舱底螺钉头；固定姿态配合可抑制后取出。
- 固定铰链采用双耳支承；活动铰链两颗螺钉防转。固定页增加圆角避让口，解决活动轴套开启时的实体碰撞。
- 铰链肩销为直径4、有效光轴长36.5，销端螺母压紧肩部，避免夹死活动页。
- 两条燕尾滑靴安装在舱底；滑轨、防退出销座与保持结构属于后续框架接口，尚未纳入本储物舱装配。
- 已检查 0、15、30、45、60、75、90 度七个姿态。配合无错误、无非预期实体干涉；每个姿态剩余8处均为M3公称螺杆与攻丝底孔的简化交叠。证据见 `validation/储物舱开启干涉检查.json`。

上述结果为离散姿态检查，不能替代连续扫掠、尺寸公差分析或实物试装。舱盖的驱动和闭合保持、快拆销的防跳脱结构仍待完成。

## AK45-10 几何来源与坐标

厂家型号为 CubeMars AK45-10 KV75，非 V3.0。厂家中文销售页显示采购入口及国内配送；外径53、总厚43 mm、完整电机参数表质量260 g。价格和驱动板选项尚未冻结。[厂家产品页](https://www.cubemars.com/cn/product/AK45-10-robotic-actuatuor.html)

从厂家 STEP 中提取后端盖、定子壳体、固定端环和输出法兰，保留原始实体几何并变换坐标：

`X=厂家X，Y=厂家Z，Z=30.5-厂家Y`，单位 mm。

因此 Z=0 为背面安装面，Z=43 为输出端面。V01 为三个外部定子构件的组合参考体，V02 为输出法兰参考体；两者合计代表一台采购电机。内部齿轮、轴承、电路和紧固件在轻量参考模型中省略，不能按其CAD体积估算完整电机质量。完整厂家装配保存在 `vendor/motor_sources/AK45-10_厂家原始三维.SLDASM`，当前77个组件实例均可解析，无缺失引用。

| 接口 | 从厂家模型提取的孔位 | 几何与使用边界 |
|---|---|---|
| 定子后端盖 | 5×M2.5，分度圆45；角度0、60、120、240、300度 | 不是五等分孔阵列。模型底孔直径2.05，圆柱段几何深度约6.634；不等同于实际有效螺纹深度 |
| 输出法兰 | 3×M2.5，分度圆27；角度-90、30、150度 | 模型底孔直径2.05，几何段Z=36～43；实际有效牙深需复核 |
| 定子安装盘 J05 | 5×直径2.9配厂家孔；4×直径3.4在50方孔上 | 圆角64方盘、厚3；背侧M2.5×8加0.5垫圈，理论旋入4.5 |
| 输出转换盘 J06 | 3×直径2.9配厂家孔；4×M3在分度圆38上 | 外径48、厚6；三处直径5.2、深3.2的沉孔容纳螺钉和小垫圈 |

输出转换盘中的 M2.5×8 螺钉配0.5厚小垫圈，理论旋入输出法兰4.7，头部低于转换盘上表面0.2。连杆使用M3×10和0.5垫圈，穿过5厚连杆后理论旋入4.5。制造释放前须复核螺纹有效深度、头部与沉孔公差叠加、预紧和防松；当前几何装配不证明连接强度。

大腿、小腿和机械臂连杆均已改为分度圆38接口。圆端R24、过渡R30与直腰相切，保留平面安装区及椭圆减重孔。大腿/小腿轴距145，机械臂连杆轴距120。旧PCD30连杆图纸不得继续用于制造。

## 国标标准件

2026-09-05 核对国家标准公开系统，下列标准状态均为现行：

- [GB/T 70.1-2008 内六角圆柱头螺钉](https://openstd.samr.gov.cn/bzgk/std/newGbInfo?hcno=AA481BA038B2F9CE68879E6B087F4F73)。
- [GB/T 97.1-2002 平垫圈 A级](https://openstd.samr.gov.cn/bzgk/std/newGbInfo?hcno=199E0585386FDF8B9CACF6225BA5F924)。
- [GB/T 848-2002 小垫圈 A级](https://openstd.samr.gov.cn/bzgk/std/newGbInfo?hcno=601DFCD4F765B4C6661BAE6227905618)。

输出沉孔使用公称2.5的小平垫圈：内径2.7、外径5、名义厚0.5；国内紧固件厂家表给出的厚度范围为0.45～0.55。该小垫圈不能换成外径6的普通系列而不改沉孔。[国内厂家尺寸表](https://www.wqjgj.cn/product/dianquan/pingdian/7985.html)

标准件模型为按尺寸绘制的简化实体，并非从大工程师库导出的原件。未下采购单，具体强度、表面处理、品牌与现货批次尚未确定。

## 仍需完成的整机工作

主框架须按实际电机重新安排髋部接口并减重；双耳支承、膝关节驱动、脚端保持、机械臂完整链路、夹爪驱动、头尾舵机、视觉/电池/计算硬件、布线、总装及完整图纸仍需继续。早期J01/J02/J03/J04概念接口不作为最终电机接口。

4～5 kg 是整机目标，尚未达成质量闭合。所有运动、爬楼、抓取和翻正指标仍需动力学及实物验证；不得以一个储物舱或一个关节模块的成功装配代替整机验收。
