Linhcry/modular-robot-pet/docs/08_后台建模工作记录.md

# 后台建模工作记录

日期：2026-09-05。遵照用户“我正在用电脑，先做后台建模与计算”，暂停大工程师的前台鼠标键盘操作，使用最小化的SolidWorks和文件计算。

## 原生模型

- F10 镂空下承载板、F11 双承载带上板、F12 端部避空承载槽梁：保留旧框架，另存独立候选。
- B01 圆润机身下护壳、B02 拱形机身背盖、B03 鼓形关节护罩：包括放样、抽壳、开口与定位止口；均不是主承载电机壳。
- Q05 分体短燕尾滑靴：4个短支点替代2条长滑靴，名义M3啮合4.5mm、螺钉末端余隙0.3mm，尚需公差与连接强度校核。
- 每件均保存为中文名称的独立SLDPRT，关闭后重新打开核对实体及重建错误。

## 装配与修复

`机身壳体与框架_空间候选.SLDASM` 包含6个实例、15个真实基准面配合。初次检查发现止口与背盖内壁碰撞、侧梁端部碰撞。已加入止口恒截面避空，并把侧梁由312mm缩至300mm；复查零配合错误、零实体干涉。该装配尚未包含紧固件、承载隔板、四腿与完整电子系统，不代表整机装配完成。

`储物舱模块_四短滑靴候选.SLDASM` 包含49个实例、96个实际配合，保留原储物舱装配。已检查舱盖0、15、30、45、60、75、90度七个离散配置：每个配置有8处螺钉公称杆与攻丝底孔的预期简化交叠，未发现其他干涉。销座、防退出锁止、驱动与导轨总装尚未完成；离散姿态不等于连续全行程证明。

## 计算

质量代入估计约9.662kg本体，另加300g货物，仍未满足4–5kg目标。现有驱动与电源电子等预留单独已有5.39kg，说明必须重新优化驱动拓扑和结构集成，仅靠板件开孔无法达到目标。

单脚150/180mm上阶分别采用245/275mm髋高，使用统一时序计算位姿、速度、加速度与摆动腿力矩。180mm阶高保持245mm髋高时，膝角最高约160.1度；升高到275mm后约148.0度。此为理想点足与集中质量模型，不能据此宣称整机已经可爬楼。

## 工程实现与参考技能

GitHub检索及本地审阅沿用 [solidworks-automation-design](../vendor/solidworks-automation-design/SKILL.md)，原仓库为 [wuuteng/codex-Solidworks-automatic-modeling-skill](https://github.com/wuuteng/codex-Solidworks-automatic-modeling-skill)。采用原生COM、实际配合、实体与变换审核；根据用户要求保留中文零件名，而不采用技能建议的尺寸型英文文件名。

SW2026当前环境将整个应用或零件设为不可见会造成草图丢线或COM异常；本阶段使用主窗口最小化、内部文档可见的方式。重复散热槽的自动尺寸求解曾停滞，已改为两条直线加两条半圆的圆头槽，并固定其生成坐标。槽尺寸由脚本参数控制；不宣称该草图为全驱动尺寸草图。

## 仍需完成

满足质量与力矩的最终驱动；大工程师对应模型；整机承载、轴承、紧固与走线；头尾及机械臂完整机构；全机装配与姿态；完整零件及装配工程图；热、功率、碰撞、稳定、制造及实物试验。

## 2026-09-07 恢复后的进展

新增独立总成 [机身框架_贯穿夹紧候选](../assemblies/机身框架_贯穿夹紧候选.SLDASM)：46个实例、135个实际基准面配合，8组M3贯穿连接和49mm压缩隔套。通过24处实际孔轴对齐检查、配合状态和实体干涉检查。名义夹紧叠厚59.5mm，M3×65经过2.4mm螺母后伸出3.1mm；该长度规格、螺纹长度、强度等级和采购可用性尚未冻结。隔套49mm只是名义匹配，尚未确定预紧与长度公差。

新增 [隔套零件工程图](../drawings/parts/F07_侧梁压缩隔套.SLDDRW) 和 [框架装配工程图](../drawings/assemblies/机身框架_贯穿夹紧候选.SLDDRW)。隔套具有外径6、孔径3.4、长度49的原生关联尺寸，主视图5:1。PDF两页均已逐页检查，修正了装配图对铝合金、PA12和钢制紧固件的混合材料说明。此装配图为结构审阅版，尚非包含剖视、零件序号、公差和完整BOM的制造放行图。最后一次COM检查确认0个打开文档。

[50项机械参考阅读](07_机械参考阅读记录_持续补齐.md) 已完成首轮：每项包括具体原始来源、章节定位、机构观察、本机取舍与适用边界。52项候选中的ANYmal D、BRUCE双足仍未计入；不靠版本、左右镜像或重复零件凑数。没有声称对全部50项完成CAD拆解或实物验证。Festo部分网页由网页工具读取，记录为文本抽取证据，未假称本地完整PDF下载。

[近端膝驱动计算](09_膝驱动近端化与传动耦合.md) 建立共同髋支架上双驱动的有符号耦合式，保持质量总量相同并移动300g以隔离惯量变化；100组虚功/反向映射校验通过，4ms到2ms步长收敛变化约0.00106Nm。没有将尚未建模的带轮、轴承及支架当作零质量。

[智能舵机筛选](10_智能舵机候选与驱动筛选.md) 比较SM80BL 12V/24V、5种外部传动比与3个关节，共30行静态/速度必要条件。R2轨迹另按同一时刻扭矩速度核算，并考虑厂家空载速度和堵转扭矩各下偏10%的敏感性。12V近端膝驱动的速度余量不足；24V仍未通过完整静态额定和热负荷要求。因此没有将12只舵机的算术减重写入正式整机质量，也没有冻结全腿通用型号。

下一阶段先收敛全机质量与按轴驱动方案，补齐承载、轴承和电源；大工程师前台模型下载仍遵守用户不占用电脑的偏好。随后完成腿根、头尾、机械臂与储物舱正向锁止的真实总装。现有9.662kg本体估计仍不满足4–5kg要求，本阶段不宣称整机建模或爬阶验证完成。

## 2026-09-07 储物舱防脱机构

新增Q06防脱销承接底座、Q07防脱销圆角跨桥、Q08圆帽防脱螺旋定位销，以及M3×12简化标准件。独立总成含20个实例、57个真实基准配合。销升0/3/6/9mm及舱退25/80/160mm七个正常配置均核对了当前组件变换；无配合错误，只有一处约69.115mm³的M6公称杆与攻丝底孔简化交叠。

对跨桥与垫圈的两处初始干涉已调整立柱避让。第一次切换配置后读取旧组件句柄不能反映新位置，已改为读取当前配置组件并逐项断言目标坐标；不使用旧坐标结果当成运动通过证据。另以两项故意越限配置验证销挡住舱耳及防脱肩挡住过行程。

跨桥由实心顶部改为3mm顶板加中心承载套，体积估算质量从49.96g降至23.00g；三个自制件合计约55.57g，不含紧固件，也不计入全机正式质量闭合。模型、正常姿态、越限检查和关联图纸均按新几何重建。说明见[储物舱防脱锁止设计](11_储物舱防脱锁止设计.md)。

本机构尚未安装到F11上板：锁座投影落在现有减重窗上，需要设计跨窗支承并统一导轨基面。9圈手拧解锁只是当前候选，防振松脱、握持操作、连续螺旋副、公差、强度和实物试装仍待完成。

## 2026-09-08 储物承载与分体背盖

新增F13支承上板、Q09导轨垫块、B04曲面主背盖、B05可拆曲面后背盖和Q10连接压板，均为独立中文SLDPRT，另导出STEP。完整储物舱与导轨锁座总成顶层47实例、138配合；套入真实护壳后发现旧背盖阻挡，已经采用曲面分体背盖解决。最终维护总成顶层22实例、64个配合特征，含子件118实例，11种离散姿态无额外实体干涉，并在重新打开后核对实际位置。

距离配合的FlipDimension在本机环境影响其他配置：现用两个互斥方向配合，避免后盖跨过基准面后导致闭合配置漂移。检查包含压板紧固件的抑制状态、真实舱盖/舱体/后盖位置及12处压板安装轴；导轨锁座另核对40处孔轴。

五张零件图与两张装配图已保存为SLDDRW，七页PDF已逐页视觉检查。最后0个打开文档。详细设计见13_储物舱承载对接与分体背盖.md。

透明观察窗要求已更新：两块主窗，第三块可选，单块面积适当放大、固定点少且可接近；仍未按未选驱动的位置在外壳上切窗。GB/T7134当前与即将实施版本状态已记录。

下一步仍需最终驱动与大工程师模型、整机减重、上板弯扭支承、背盖螺母防掉落及工具空间、窗口面板/边框、腿根/头尾/机械臂与全机装配。没有把几何无干涉称为强度通过，也没有把未选舵机的算术减重计入全机质量。

## 2026-09-08 触控头部齐平嵌入

新增H04曲面头壳、H05齐平面框、H06屏幕承架和隐藏走线槽、H07柔性密封圈；保留V03厂家2.8寸触控屏的10个实体。用户要求无缝嵌入后，取消0.8mm凹入，改为玻璃/面框/柔性圈前面同Z62.2。柔性圈背部承边被0.6mm薄唇和槽肩捕获，需试样验证弹性装配、公差、薄唇耐久，不作为模具制造图。

五组件、12个真实基准配合；重开后12组孔轴复核通过，名义装配无实体干涉，三个齐平面实测一致。四张独立零件图和一张装配图保存为SLDDRW；五页合册完成逐页视觉检查。每件完成后保存关闭，最后0个打开文档。

SM105BL-C001厂家规格书已下载并阅读尺寸/曲线。5.3kg目标含载荷、R1.5传动的三局部姿态与电动摆动区预筛通过；10kg敏感性中髋俯仰/膝额定不足。仍不能冻结驱动：大工程师模型、整机减重、带轮与轴承、制动回生/热与噪声待补。CM5-NANO-A厂家STEP已下载但SW导入失败，本轮未获得底板原生模型。

接续：屏幕螺柱M2.5名称与内孔几何口径核对、头部全部紧固件/工具路径、相机真实接口和视场、CM5散热及接插件、颈部线缆与负载、透明观察窗、全机动作/质量与强度复核。详细记录见14和15号文档。

## 2026-09-08 承架紧固与电子厂家几何核对

头部承架四孔由X±37外移到±39，Y仍±28。原位置下方两孔的D5直进工具杆与厂家玻璃各交叠约3.753mm³；外移后排除。H04/H06原生件、STEP和两张零件图同步更新为78mm孔横距，旧件及旧五页合册保存到wip历史目录。

新增承架紧固总成21组件、44个配合，四组M3×10螺钉/双面垫圈/M3螺母采用实际孔同心与承压面贴合。重新打开后无配合错误和实体干涉；拆下面框时，四处D5×60直进通道避开头壳、承架、屏幕和全部新增紧固件。背面螺母防掉落、扳手路径、PA12预紧压溃/蠕变仍待完善。

新增“面框拆下_承架紧固”配置；完整→拆面框→完整的恢复检查通过。装配工程图主视图引用拆面框配置，其他视图引用完整配置。五页合册更新为一张紧固装配图及四张独立零件图，逐页视觉检查完成；原生引用件、图纸、STEP及审计按白名单打包，并检查ZIP中每个文件的SHA256。

V04微雪CM5-NANO-A底板导入恢复成功，337实体已保存为中文原生件。原理图与STEP位号核对显示核心板连接器、MIPI等器件的标签无法对应，且PCB未发现常规安装孔；不能把空白背面或核心板孔距直接当作底板安装基准。CM5官方核心板STEP、38页数据手册和底板原理图均已下载并记录来源及哈希。V05核心板1076实体已保存关闭，原生件约48.1MB；预览已查看，独立接口复核见CM5核心板与底板精确接口.json。

相机候选对应Pi5-IMX219-77（SKU26184）；对角视场79.3°、名义F2.0和暂定0.5mm偏心预算下，D16窗口允许入瞳后缩约8.19mm。这个条件计算不等于实拍无遮挡，托架高度仍须真实入瞳、板厚、孔位和排线连接器数据。

新增头部自制结构估重125.25g，比旧H01/H02增加70.97g；未把外观和触控功能改进写成减重。整机4–5kg目标仍未实现，驱动/结构/完整电子与线束质量需要继续收敛。

头部紧固件对应GB/T70.1-2008、GB/T97.1-2002、GB/T6170-2015，均已通过官方系统核实为现行。M3螺母最大对边5.50/厚2.40mm与国内采购平台和厂家尺寸表交叉一致。增加8种21件装配清单；材料等级、表面处理、全公差和大工程师具体供货模型仍待冻结，没有下单。

## 2026-09-08 螺母防落改版与STEP完整性问题

H10/H11曲面定位头壳及长臂螺母杯已各自保存为原生单实体零件，零特征重建错误。新杯原点Z37.6，名义卸载间隙0.6mm；完整装配、安装路径与新工程图尚未完成。杯内独立检查完成4种状态、6个旋转反例，不代表头壳或实物装配通过。

轻量独立读取发现H04/H08/H10 STEP各有两条缺失曲线引用，不能用其不完整转换体验证无干涉。旧审阅包内的H04 STEP确认受影响，已补已知问题说明，并在重打包前增加拦截。原生SLDPRT是否存在相应几何问题尚需SolidWorks检查。详见 docs/16_螺母防落结构与STEP导出接续.md。
