Linhcry/modular-robot-pet/docs/09_膝驱动近端化与传动耦合.md

# 膝驱动近端化与同步带耦合计算

2026-09-07。此项用于比较传动拓扑，不是电机选型完成，也不是整机爬楼验证。

把膝附近的300g移至髋俯仰轴处，膝端保留40g，保持本次单腿质量总和不变。附加带轮、轴承、张紧件、保护罩没有凭空计为零质量；整机减重收益必须待这些件建模后重新核算。

研究方案的两个电机定子均安装在髋外展后的共同支架上，近端带轮与髋轴同轴，带轮绝对角为a，大腿角为h，膝相对大腿角为k。理想关系为 a=h+Rk。电机力矩应为 τa=τk/R、τh电机=τh−τk/R，转速为 ȧ=ḣ+Rk̇。若定子安装在运动大腿上，关系不同，不能复用此式。

| 方案 | 电机 | 摆动峰值 Nm | 最高转速 rpm | 摆动 RMS Nm |
|---|---|---:|---:|---:|
| 原膝端电机 | 髋外展电机 | 0.545 | 0.00 | 0.492 |
| 原膝端电机 | 髋俯仰电机 | 0.681 | 38.46 | 0.415 |
| 原膝端电机 | 膝驱动电机 | 0.236 | 41.02 | 0.194 |
| 电机近端化_独立随动传动 | 髋外展电机 | 0.513 | 0.00 | 0.491 |
| 电机近端化_独立随动传动 | 髋俯仰电机 | 0.255 | 38.46 | 0.186 |
| 电机近端化_独立随动传动 | 膝驱动电机 | 0.236 | 41.02 | 0.194 |
| 共髋轴同步带_R1 | 髋外展电机 | 0.513 | 0.00 | 0.491 |
| 共髋轴同步带_R1 | 髋俯仰电机 | 0.456 | 38.46 | 0.283 |
| 共髋轴同步带_R1 | 膝驱动电机 | 0.236 | 31.80 | 0.194 |
| 共髋轴同步带_R1.5 | 髋外展电机 | 0.513 | 0.00 | 0.491 |
| 共髋轴同步带_R1.5 | 髋俯仰电机 | 0.389 | 38.46 | 0.237 |
| 共髋轴同步带_R1.5 | 膝驱动电机 | 0.158 | 39.48 | 0.130 |
| 共髋轴同步带_R2 | 髋外展电机 | 0.513 | 0.00 | 0.491 |
| 共髋轴同步带_R2 | 髋俯仰电机 | 0.355 | 38.46 | 0.219 |
| 共髋轴同步带_R2 | 膝驱动电机 | 0.118 | 59.97 | 0.097 |
| 共髋轴同步带_R2.5 | 髋外展电机 | 0.513 | 0.00 | 0.491 |
| 共髋轴同步带_R2.5 | 髋俯仰电机 | 0.335 | 38.46 | 0.209 |
| 共髋轴同步带_R2.5 | 膝驱动电机 | 0.095 | 80.47 | 0.078 |
| 共髋轴同步带_R3 | 髋外展电机 | 0.513 | 0.00 | 0.491 |
| 共髋轴同步带_R3 | 髋俯仰电机 | 0.322 | 38.46 | 0.203 |
| 共髋轴同步带_R3 | 膝驱动电机 | 0.079 | 100.97 | 0.065 |

这些值来自同一条2.1s的180mm上阶摆动轨迹，髋固定275mm高，全程足端外力为零。独立随动传动一行仅表示同样关节轨迹下质量位置变化的对照；不代表该传动可无质量实现。所有数值未乘选型裕量。

若膝轴需求为7.5Nm，40齿、3mm节距从动轮的紧松边张力差约392.7N。这个量级说明同步带方案必须另设承载轴承和刚性支座，不能把带轮直接挂在没有径向承载数据的小电机输出轴上。这里没有据此选定带宽或标准件。

决策：保留近端化作为候选，不能因膝驱动扭矩除以传动比而宣称整腿电机都可缩小。优先补齐总成质量、髋电机耦合负荷、预紧力与轴承载荷，再决定是否画完整传动。原有AK候选装配仍保留作尺寸和载荷对照。

校验：100组确定种子随机虚功及反向力矩映射检查通过；同一轨迹最大功率映射误差2.22e-16W；4ms减至2ms后摆动力矩峰值最大变化0.00106Nm。

研究动机参见[Doggo机械说明](https://github.com/Nate711/StanfordDoggoProject)、[HyperDog的近端集中驱动与腿结构](https://arxiv.org/abs/2209.09171)。本文公式和本宠物结论为独立工程推导，未把参考机型性能当成本机性能。
