Linhcry/modular-robot-pet/docs/12_透明观察窗与维护空间规划.md

# 透明观察窗与维护空间规划

更新：2026-09-08。需求已纳入设计；本文件是布局与接口约束，不表示观察窗零件已完成。

## 数量与布置

整机先按两块主观察窗设计，第三块仅在内部布局确实具有展示价值且不削弱维护空间时增设。主观察窗优先展示左右关节的传动结构；第三块考虑展示储物舱的导轨与防脱机构。禁止把机身切成大量细小窗口。实际可视范围须在电机、轴承、走线与壳体总装后确认，不能仅凭外壳投影确定。

主窗初步目标为每块约80～110mm长、45～65mm宽的圆角开口。此为布置目标，尚未冻结尺寸；若驱动件遮挡严重，应调整整块窗的位置与轮廓，而不是继续增加小孔。孔间保留连续边框，并避免把主承载板的减重孔直接当作外观观察窗。

外形采用大圆角和平缓曲线，与实体壳体曲面连续呼应；透明板自身优先平板，承接在壳体局部平面座上，避免为追随复合曲面而强迫亚克力弯曲装配。两块主窗尽量共用规格或镜像结构，减少加工和维护成本。

## 可拆装接口

每块观察窗独立拆卸，优先四个可接近的固定点。窗口周边应留出手指、批头和取板空间；固定件不能埋在电机后方，也不能要求先拆整条腿才能更换面板。最终装配必须检查螺钉旋入轴线附近的工具包络，以及松开后面板的真实取出路径。

初步采用2～3mm浇铸型透明PMMA板、软质隔离垫和金属限压套/肩部。夹紧力经限压结构传递，避免直接压裂板材。透明板不承担关节反力或机身主承载作用。不在薄亚克力中直接攻承载螺纹，不用强力胶永久封死维护窗口。

定位采用一个固定基准点配合其余浮动孔/长孔的思路。孔径、边距、软垫厚度和限压长度须结合实际板材、紧固件和加工工艺冻结；不能仅按螺钉公称直径打无间隙孔。孔口去锐边，避免产生缺口和裂纹。先完成装配公差链，再给出制造尺寸。

供应商PLEXIGLAS对其常规GS/XT材料提出约5mm/m的整体膨胀预留参考，并建议螺接避免过度夹紧。本项目暂用它作为布置参考：100mm跨度约对应0.5mm整体余量；这不是任意国产PMMA牌号的保证值，也不能代替具体温湿度范围下的材料数据。

## 观察与散热

观察窗面对有辨识度的轴、皮带轮、齿轮或导轨机构，避免正对密集线束。框架、线束固定和驱动器布局应共同整理可视区域。保留窗内运动间隙，检查最大关节角度下零件不碰板；窗边与散热口分别布置，透明板不得盖住驱动器和电机的必要散热路径。

透光、眩光、划伤以及清洁剂相容性需样件确认；如摄像头需要透过透明板成像，必须另外验证反射与畸变，不能直接沿用机械观察窗。

## 中国标准状态与来源

截至2026-09-08，国家标准信息目录显示GB/T 7134—2008《浇铸型工业有机玻璃板材》仍现行。GB/T 7134—2026于2026-07-02发布，2027-02-01实施，当前为即将实施；采购时按实际采购日期复核。目录状态核验不等于已获得并逐条核验标准全文。

- 国家标准信息目录：<https://openstd.samr.gov.cn/bzgk/std/std_list?p.p1=0&p.p2=GBT+7134&p.p90=circulation_date&p.p91=desc>
- GB/T 7134—2026条目：<https://openstd.samr.gov.cn/bzgk/std/newGbInfo?hcno=06C898DCC2785060EFFAE7BC6AD87ED7>
- PLEXIGLAS连接指南，第6节螺接：<https://www.plexiglas.de/files/plexiglas-content/pdf/verarbeitungsrichtlinie/311-3-EN-joining-PLEXIGLAS.pdf>
- PLEXIGLAS机械加工指南，第3.4节：<https://www.plexiglas.de/files/plexiglas-content/pdf/verarbeitungsrichtlinie/311-1-Machining-PLEXIGLAS.pdf>

后续交付：独立中文SLDPRT面板与边框、板材加工图、含实际固定件的装配、拆装与运动间隙审核。尚未采购，尚未实物试装。
