Linhcry/modular-robot-pet/docs/14_SM105舵机与近端驱动预筛.md

# SM105BL-C001候选筛选

2026-09-08。厂家规格书与本机局部模型预筛，尚未冻结采购和接口。

标称额定4.903Nm，堵转14.710Nm，空载60rpm，200±3g，9–16V输入；规格书日期2025-05-28。

[厂家产品页](https://www.feetechrc.com/861651.html)。厂家PDF和SHA256见验证JSON。

| R1.5轴 | 带余量静态 Nm | 对额定比 | 摆动最高 rpm |
|---|---:|---:|---:|
| 髋外展 | 2.096 | 0.43 | 0.00 |
| 髋俯仰 | 2.375 | 0.48 | 38.46 |
| 膝驱动 | 3.602 | 0.73 | 39.48 |

R1.5可继续进入传动详细设计，依据是以上有限工况的预筛；不能据此宣布全机动作可行。电动摆动区逐时刻比较力矩和速度，并将厂家曲线两端点各下调10%；制动区单独保留未验证。

| 含载荷总质量 kg | 髋外展 Nm | 髋俯仰 Nm | 膝驱动 Nm |
|---|---:|---:|---:|
| 5.3 | 2.096 | 2.375 | 3.602 |
| 7.0 | 3.030 | 3.308 | 4.826 |
| 10.0 | 4.678 | 4.954 | 6.986 |

以上改变总反力而保留单腿质量参数，仅为重量敏感性。当前旧方案约9.66kg的估重不能被5.3kg目标工况替代；总机减重是这套轻驱动成立的前提。

- 沿用原单腿质量，5.3kg为目标含载荷质量；另算7/10kg反力敏感性，不是重建完整质量惯量模型
- 1.3/0.85为设计余量代理；静态没有功率效率含义
- 三种局部支撑姿态不能证明全机平衡或楼梯可靠性
- 曲线为厂家图的直线端点近似；四象限、温升及连续热包络未验证
- PDF第5页只给出70摄氏度关断，未列过流阈值；不能套用SM80的2.5A/2s
- 页6标注舵机噪声70±5dB且无防水，宠物安静目标需实测，不能按马达45dB宣传
- 页面型号与PDF型号写法不同、配件栏文字No Accessories但有舵盘图，供货版本需确认
- 厂家图12-M2.5x3深孔、舵盘8-M3 PCD21和总高49.1已阅；仍须大工程师对应型号三维核对
- R1.5同步带的轴承、张紧、带宽和新增质量未设计；不把仅电机减重直接记为整机减重
