Linhcry/modular-robot-pet/data/触控头部承架紧固装配清单.csv

序号 | 编号 | 中文名称 | 数量 | 标准或来源 | 规格或尺寸 | 零件文件 | 采购状态 | 限制
1 | H04_TouchHeadShell | 触控视觉曲面头壳 | 1 | 本项目自制候选 | 四段圆角放样，深60，壁2.5；前面104×96；承托肩顶Z49.2，安装孔±39/±28；后壁D18穿线 | H04_触控视觉曲面头壳.SLDPRT | 未制造释放 | 玻璃与面框齐平，黑色柔性圈收口。屏幕孔位来自厂家STEP；相机、散热与颈部线缆待定型。未制造释放。
2 | H05_TouchBezel | 触控屏与镜头圆角面框 | 1 | 本项目自制候选 | 104×96×2.2 R20；屏口72.3×53.9；背面沉台76.7×58.3深1.2；防脱薄唇厚0.6 | H05_触控屏与镜头圆角面框.SLDPRT | 未制造释放 | 玻璃与面框齐平，黑色柔性圈收口。屏幕孔位来自厂家STEP；相机、散热与颈部线缆待定型。未制造释放。
3 | H06_ScreenBracket | 触控屏承架与隐藏走线槽 | 1 | 本项目自制候选 | 88×84×2 R20；屏孔X=-29.35/30.12，Y=8.45/-32.45，D2.9；安装孔±39/±28 D3.4 | H06_触控屏承架与隐藏走线槽.SLDPRT | 未制造释放 | 玻璃与面框齐平，黑色柔性圈收口。屏幕孔位来自厂家STEP；相机、散热与颈部线缆待定型。未制造释放。
4 | H07_ScreenSeal | 触控屏齐平柔性密封圈 | 1 | 本项目自制候选 | 装配态：内71.3×52.9 R3；唇外72.3×53.9 R3.5；承边外76.3×57.9 R5.5；总高1.6 | H07_触控屏齐平柔性密封圈.SLDPRT | 未制造释放 | 装配态名义几何；自由态过盈量、硅胶硬度及压缩量待试样验证，不能据此直接开模。
5 | V03_DsiScreen | 微雪2点8寸触控屏厂家参考 | 1 | Waveshare原厂STEP | 厂家原始坐标；详见接口提取审计 | V03_微雪2点8寸触控屏厂家参考.SLDPRT | 后续采购；无下单 | 未采购。原厂STEP派生，非大工程师模型。
6 | S01_M3x10 | M3内六角螺钉简化实体 | 4 | GB/T 70.1-2008 | M3×10；头外径5.5、头高3mm；螺纹与内六角简化 | S01_M3x10_M3内六角螺钉简化实体.SLDPRT | 后续采购；无下单 | 尚未取得大工程师对应模型；材料等级、表面处理、公差和供货版本未冻结
7 | S02_M3Washer | M3平垫圈简化实体 | 8 | GB/T 97.1-2002 | 内径3.2、外径7、厚0.5mm | S02_M3平垫圈简化实体.SLDPRT | 后续采购；无下单 | 尚未取得大工程师对应模型；材料等级、表面处理、公差和供货版本未冻结
8 | S03_M3Nut | M3螺母简化实体 | 4 | GB/T 6170-2015 | M3；对边5.5、厚2.4mm；未建牙型 | S03_M3螺母简化实体.SLDPRT | 后续采购；无下单 | 尚未取得大工程师对应模型；材料等级、表面处理、公差和供货版本未冻结
