Linhcry/modular-robot-pet/parts/H12_带可换相机接口的屏幕承架.SLDPRT

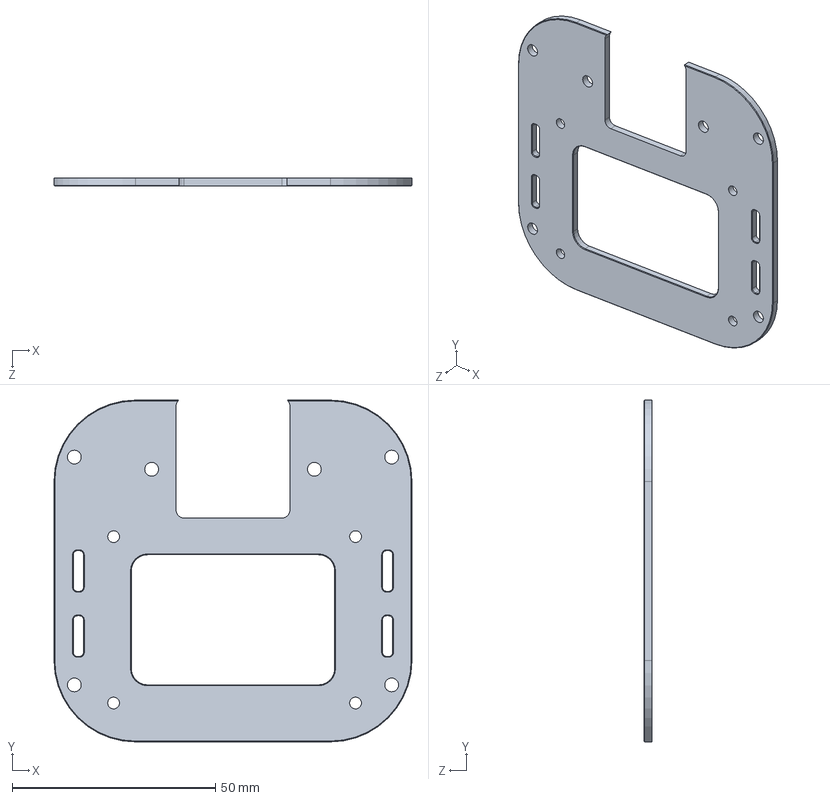
[picture p3: CAD file, 2026-10-19]
parts/H12_带可换相机接口的屏幕承架.SLDPRT
88.0 x 84.0 x 2.00 mm
