Linhcry/modular-robot-pet/parts/H13_四点绝缘可换相机托架.SLDPRT

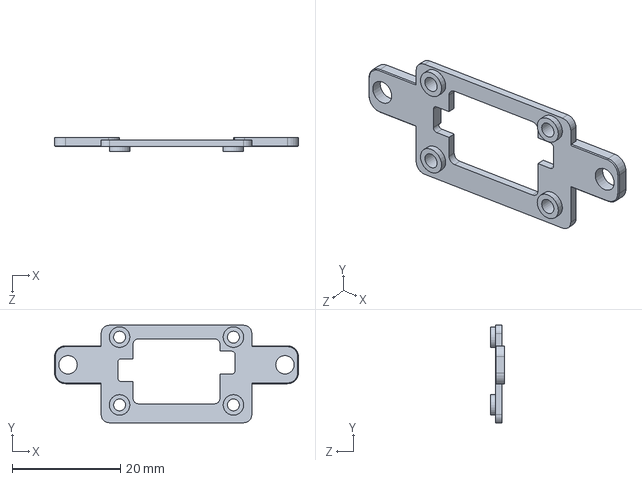
[picture p4: CAD file, 2026-10-19]
parts/H13_四点绝缘可换相机托架.SLDPRT
45.0 x 18.0 x 2.64 mm
