Linhcry/modular-robot-pet/docs/16_螺母防落结构与STEP导出接续.md

# 螺母防落结构与 STEP 导出接续

本记录对应 2026-09-08 后台建模。H10/H11 是新的配对候选，不能混用 H08/H09 的安装高度。整机目标和原生 SolidWorks 交付要求未改变。

## 已保存零件

| 零件 | 当前设计 | 保存及检查 |
|---|---|---|
| H10 宽槽螺母杯定位曲面头壳 | 沿用曲面外壳和 78×56 承架孔距；四个 13×13 圆角定位座、D9.0 入口、1.8 高卡槽 | 原生 SLDPRT 已保存关闭，单实体、零特征重建错误；STEP 导出发现缺失曲线问题 |
| H11 长臂卡扣螺母防落杯 | 16×16 圆角底盖，D8.4 杯体，AF5.7 六角槽，长弹性臂厚0.6、根部R0.4 | 原生 SLDPRT 已保存关闭；STEP 单实体有效且体积与原生记录一致 |

H11 装配原点 Z37.6；止挡顶面局部 Z4.5 对齐头壳 Z42.1；杯内底局部 Z5.6，即全局 Z43.2。拧紧后的最大包络螺母底 Z43.8，名义卸载间隙0.6。松放螺母底局部Z5.6，垫圈底局部Z8.0；拧紧后垫圈底全局Z46.2。

H10体积88779.384947mm³，按PA12密度1010kg/m³假设为89.667g；H11每件568.108272mm³、0.574g。保持力、实际材料及全机质量尚未确认。

## 尺寸链发现与改进

H08/H09 的直径间隙、杯底卸载间隙、卡槽轴向总间隙均只有0.2mm。以塑料功能尺寸独立±0.10mm、垫圈厚度±0.05mm作灵敏度假设，杯底卸载间隙可变为−0.15mm，因而不能直接宣称杯底始终不承受夹紧力。

H10/H11将直径间隙和杯底卸载间隙增至0.6mm，径向扣合量增至1.0mm，卡槽轴向总间隙增至1.0mm。按塑料功能尺寸独立±0.15mm的条件核算，杯底最小卸载间隙0.1mm；考虑最大径向偏移后的扣合量保守下界0.25mm。这些误差是假设，不是供应商能力或制造放行公差。

增大扣合深度也增加装入挠曲。当前简化梁应变量级在不利尺寸与偏心叠加条件下约4.10%，尚未作材料与疲劳判定，必须以真实PA12工艺、打印方向和试样验证。

最小对边5.32mm的M3螺母在AF5.7槽中有约8.11°单向居中游隙。原8°反例只适用于当前最大包络模型，不能覆盖所有尺寸范围。

计算依据：`validation/螺母杯尺寸链与公差敏感性.json`、`validation/长臂螺母杯尺寸链核算.json`。原生记录：`validation/长臂螺母杯零件检查.json`。

## STEP 导出问题

独立读取8个头部STEP后，H04/H08/H10各发现两条 `EDGE_CURVE` 的曲线引用为 `$`，即缺少曲线定义。当前OCCT读取时各有34个面落在实体之外；不能对这些不完整转换体做无干涉判断，也不能据此直接认定原生SLDPRT损坏。

H05/H06/H07/H09/H11在本轮读取中没有上述缺失定义和实体外面。H11的STEP体积与SolidWorks记录一致。检查报告含文件哈希、错误实体号和转换日志：`validation/头部STEP导出完整性检查.json`。

之前的五页审阅包内含H04 STEP，因此该STEP的跨CAD可用性有已知问题；原生配合审计和图纸检查仍是其原有范围的证据，不能延伸成STEP完整性通过。打包脚本现在会在覆盖ZIP之前拒绝含缺失曲线引用的STEP。

## 接续顺序与资源约束

1. 单独打开H10，检查原生体及缺失边附近的曲线；尝试另存AP214/其他导出路径，逐次保留文件并比较有效闭合体、体积与关键接口。不要用直线猜补缺失的曲面边。
2. 修复导出后，运行完整H10/H11安装路径检查；杯内单独检查不代替头壳、屏幕和工具路径。
3. H10/H11独立SLDDRW已完成并渲染查看。
4. 25组件、52配合的头部原生装配和装配工程图已完成；默认、面框拆下、恢复默认三次配置检查通过。旧H08/H09装配脚本不能直接充当H10/H11装配。

用户最新明确要求“现在直接做，暂时不管内存”。`data/cad_runtime_policy.json`已将低内存处理设为warn：记录原门限检查结果，但不因可用内存不足阻止SolidWorks任务。继续单件或单装配顺序处理、保存关闭，不关闭其他用户应用。独立STEP校验使用不含VTK的OCCT绑定，单进程顺序执行；本轮8文件扫描峰值工作集约249MiB。该辅助工具不替代SolidWorks交付。

工具来源：[OCP无VTK包](https://pypi.org/project/cadquery-ocp-novtk/7.9.3.1.1/)、[CadQuery构建项目](https://github.com/CadQuery/ocp-build-system)。

## 后续：等参边重建候选与离散路径检查

已从两侧原有B样条曲面的恒U边界重建两条缺失曲线。每条取101个样本检查与两侧曲面的距离，最大约0.000029mm；端点最大偏差约0.000062mm。候选读回为一个有效闭合实体，没有实体外面。

`wip/STEP修复候选/H10_宽槽螺母杯定位曲面头壳_保留原始实体号.STEP`保留原始81746个实体的编号及定义，只替换两条缺失曲线引用并追加208个曲线/控制点实体。`validation/头壳STEP修复实体差异检查.json`确认除此之外无其他实体定义变化。旧整模型重写候选保留作对照，不能混淆两者哈希。

体积门限仍未通过：当前OCCT自适应积分约88667.47mm³，原生GetMassProperties记录88779.38mm³，相差约111.91mm³（0.126%）。OCCT积分精度改变时有约1mm³级变化，不能把门限放宽后直接宣称与原生一致。

最新已运行`diagnose_native_head_export.py`：只读打开H10，实体Check2原始返回0，无三维曲线边数0；三档质量属性重算均为88779.384947mm³。另存AP214仍有两条缺失曲线引用，未解决原问题。原生SLDPRT文件哈希前后相同。报告见`validation/原生头壳高精度体积与AP214检查.json`。

H10/H11独立SLDDRW和对应PDF已生成，8项模型关联尺寸读取一致。两页PDF已渲染查看，视图、中文及标注无裁切；这些是结构审阅图，尚未冻结制造公差。

第一份等参边重建候选（文件名以`_等参边重建.STEP`结尾）已完成四孔位64个离散路径样本、32个几何反例，未发现预期卡钩挠曲区以外的异常，校验进程峰值工作集290MiB。记录见`validation/长臂螺母杯_修复STEP候选路径检查.json`，其中明确标注原生体积等价门限未通过。后生成的保留原始实体号候选完成实体差异与闭合检查，未重跑全部路径；两份均未完成SolidWorks回读或原生装配配合验证。

路径检查不是连续柔性装配仿真；它不证明卡扣应力、保持力、实际打印公差、工具释放、人手空间或实物可装配。正式STEP、原生零件和旧审阅包均未被这些候选替换。

## 最新原生装配与导出诊断

`assemblies/触控视觉头部_长臂螺母防落候选.SLDASM`已保存。25个组件、52个真实配合，20个紧固件/杯的原点偏差小于0.0001mm；原生全装配无名义刚性干涉。重开后配合和默认配置干涉再次检查通过，面框拆下配置只抑制H05/H07。报告见`头部长臂螺母防落装配检查.json`及`长臂头部装配图与重开检查.json`。

原生Parasolid离散路径检查完成64个位置、24个限位反例；12个位置的交叠只位于预期卡钩挠曲区。这里引用SLDPRT实体复制体，未使用有问题的STEP。报告`长臂螺母杯安装路径检查.json`。不包含连续路径、卡扣变形应力、保持力及卸扣工具验证。

手工补边候选已回读SolidWorks：单实体，但Check2返回2，体积较原生增加604.1548mm³；双向差集都返回1058（swBodyOperationBooleanFail）。失败时空结果不是零差异，候选不可替换正式几何。

原导出设置为AP203、拆分周期面=true。对H10切换AP214并关闭周期面拆分后，缺失曲线数从2变0，STEP面数从154恢复到原生134。然而独立OCCT体积比原生大230.9889mm³；再次回读SolidWorks体积比原生小1079.8529mm³，双向差集仍失败。故关闭拆分只消除了文件中的缺失引用，尚未证明转换几何正确。

原生源SLDPRT在只读诊断前后哈希不变。所有有问题的候选保留在wip，仅用于追溯。最新审阅包交付原生SLDPRT、SLDASM、SLDDRW及PDF，明确不交付未通过的头壳STEP。后续应检查原生放样/抽壳的曲面参数化及可稳定导出的重建方式，保留现有接口和装配。

接续工作仍包括屏幕及面框自身完整紧固、相机真实模型与光路、CM5安装及散热、颈部线束、大工程师电机模型、传动减重和透明窗。整机尚未制造释放。
